Jay-esp/cb_external_pll_controller/master/design_2_0/cb_pll_master_2_0_empty.png

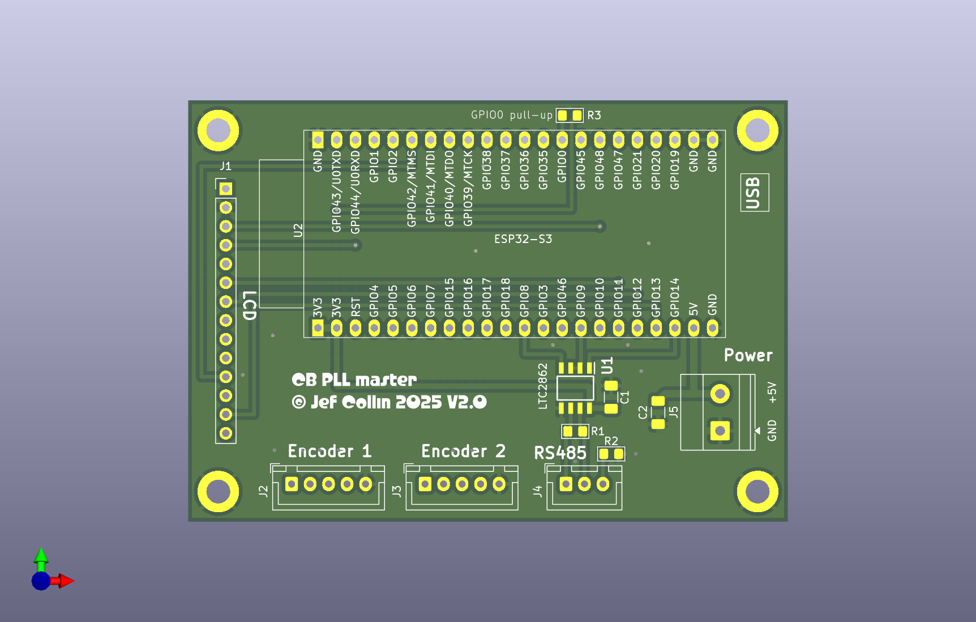
master/design_2_0/cb_pll_master_2_0_empty.png
