Jay-esp/cb_external_pll_controller/slave/design_1_2/cb_pll_slave_1_2.png

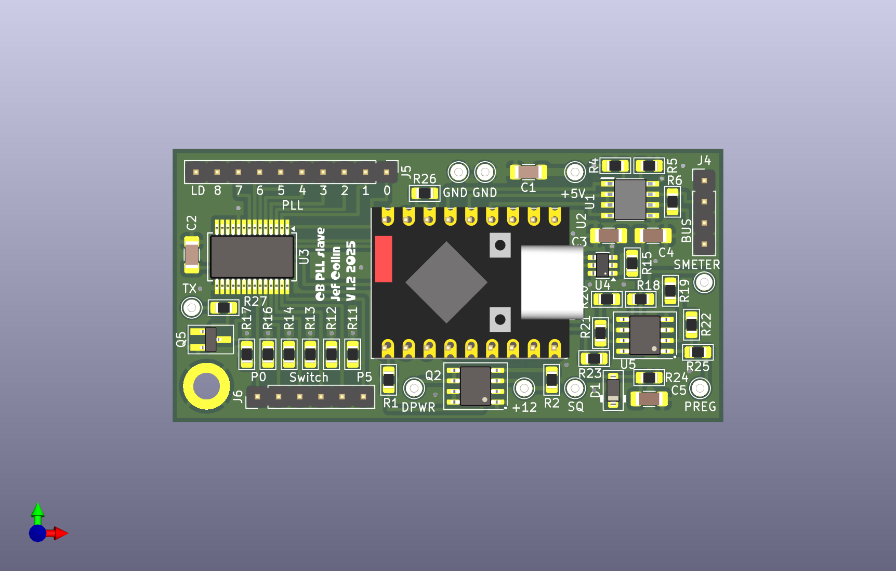
slave/design_1_2/cb_pll_slave_1_2.png
