Jay-esp/cb_external_pll_controller/master/src/cb_master_w21/dseg7_100.c

/*******************************************************************************
 * Size: 100 px
 * Bpp: 1
 * Opts: --bpp 1 --size 100 --no-compress --stride 1 --align 1 --font DSEG7Classic-Regular.ttf --symbols  0123456789., --format lvgl -o dseg7_100.c
 ******************************************************************************/

#ifdef __has_include
    #if __has_include("lvgl.h")
        #ifndef LV_LVGL_H_INCLUDE_SIMPLE
            #define LV_LVGL_H_INCLUDE_SIMPLE
        #endif
    #endif
#endif

#ifdef LV_LVGL_H_INCLUDE_SIMPLE
    #include "lvgl.h"
#else
    #include "lvgl/lvgl.h"
#endif



#ifndef DSEG7_100
#define DSEG7_100 1
#endif

#if DSEG7_100

/*-----------------
 *    BITMAPS
 *----------------*/

/*Store the image of the glyphs*/
static LV_ATTRIBUTE_LARGE_CONST const uint8_t glyph_bitmap[] = {
    /* U+0020 " " */
    0x0,

    /* U+002E "." */
    0xf, 0x3, 0xfc, 0x7f, 0xe7, 0xfe, 0xff, 0xff,
    0xff, 0xff, 0xff, 0xff, 0x7f, 0xe7, 0xfe, 0x3f,
    0xc0, 0xf0,

    /* U+0030 "0" */
    0x1, 0xff, 0xff, 0xff, 0xff, 0xff, 0xfe, 0x0,
    0xf, 0xff, 0xff, 0xff, 0xff, 0xff, 0xfc, 0x0,
    0x7f, 0xff, 0xff, 0xff, 0xff, 0xff, 0xf8, 0x1,
    0xff, 0xff, 0xff, 0xff, 0xff, 0xff, 0xe0, 0x3,
    0xff, 0xff, 0xff, 0xff, 0xff, 0xff, 0x0, 0xc7,
    0xff, 0xff, 0xff, 0xff, 0xff, 0xf8, 0xc7, 0x8f,
    0xff, 0xff, 0xff, 0xff, 0xff, 0xc7, 0xbf, 0x1f,
    0xff, 0xff, 0xff, 0xff, 0xfe, 0x3f, 0xfe, 0x3f,
    0xff, 0xff, 0xff, 0xff, 0xf1, 0xff, 0xfc, 0x0,
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
    0x80, 0x0, 0x0, 0x0, 0x0, 0x7, 0xff, 0xfe,
    0x0, 0x0, 0x0, 0x0, 0x0, 0x1f, 0xff, 0xf8,
    0x0, 0x0, 0x0, 0x0, 0x0, 0x7f, 0xff, 0xe0,
    0x0, 0x0, 0x0, 0x0, 0x1, 0xff, 0xff, 0x80,
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
};


/*---------------------
 *  GLYPH DESCRIPTION
 *--------------------*/

static const lv_font_fmt_txt_glyph_dsc_t glyph_dsc[] = {
    {.bitmap_index = 0, .adv_w = 0, .box_w = 0, .box_h = 0, .ofs_x = 0, .ofs_y = 0} /* id = 0 reserved */,
    {.bitmap_index = 0, .adv_w = 320, .box_w = 1, .box_h = 1, .ofs_x = 0, .ofs_y = 0},
    {.bitmap_index = 1, .adv_w = 0, .box_w = 12, .box_h = 12, .ofs_x = -6, .ofs_y = 0},
    {.bitmap_index = 19, .adv_w = 1306, .box_w = 62, .box_h = 100, .ofs_x = 10, .ofs_y = 0},
    {.bitmap_index = 794, .adv_w = 1306, .box_w = 9, .box_h = 92, .ofs_x = 62, .ofs_y = 4},
    {.bitmap_index = 898, .adv_w = 1306, .box_w = 62, .box_h = 100, .ofs_x = 10, .ofs_y = 0},
    {.bitmap_index = 1673, .adv_w = 1306, .box_w = 57, .box_h = 100, .ofs_x = 14, .ofs_y = 0},
    {.bitmap_index = 2386, .adv_w = 1306, .box_w = 62, .box_h = 91, .ofs_x = 10, .ofs_y = 5},
    {.bitmap_index = 3092, .adv_w = 1306, .box_w = 62, .box_h = 100, .ofs_x = 10, .ofs_y = 0},
    {.bitmap_index = 3867, .adv_w = 1306, .box_w = 62, .box_h = 100, .ofs_x = 10, .ofs_y = 0},
    {.bitmap_index = 4642, .adv_w = 1306, .box_w = 62, .box_h = 96, .ofs_x = 10, .ofs_y = 4},
    {.bitmap_index = 5386, .adv_w = 1306, .box_w = 62, .box_h = 100, .ofs_x = 10, .ofs_y = 0},
    {.bitmap_index = 6161, .adv_w = 1306, .box_w = 62, .box_h = 100, .ofs_x = 10, .ofs_y = 0}
};

/*---------------------
 *  CHARACTER MAPPING
 *--------------------*/

static const uint16_t unicode_list_0[] = {
    0x0, 0xe
};

/*Collect the unicode lists and glyph_id offsets*/
static const lv_font_fmt_txt_cmap_t cmaps[] =
{
    {
        .range_start = 32, .range_length = 15, .glyph_id_start = 1,
        .unicode_list = unicode_list_0, .glyph_id_ofs_list = NULL, .list_length = 2, .type = LV_FONT_FMT_TXT_CMAP_SPARSE_TINY
    },
    {
        .range_start = 48, .range_length = 10, .glyph_id_start = 3,
        .unicode_list = NULL, .glyph_id_ofs_list = NULL, .list_length = 0, .type = LV_FONT_FMT_TXT_CMAP_FORMAT0_TINY
    }
};



/*--------------------
 *  ALL CUSTOM DATA
 *--------------------*/

#if LVGL_VERSION_MAJOR == 8
/*Store all the custom data of the font*/
static  lv_font_fmt_txt_glyph_cache_t cache;
#endif

#if LVGL_VERSION_MAJOR >= 8
static const lv_font_fmt_txt_dsc_t font_dsc = {
#else
static lv_font_fmt_txt_dsc_t font_dsc = {
#endif
    .glyph_bitmap = glyph_bitmap,
    .glyph_dsc = glyph_dsc,
    .cmaps = cmaps,
    .kern_dsc = NULL,
    .kern_scale = 0,
    .cmap_num = 2,
    .bpp = 1,
    .kern_classes = 0,
    .bitmap_format = 0,
#if LVGL_VERSION_MAJOR == 8
    .cache = &cache
#endif

};



/*-----------------
 *  PUBLIC FONT
 *----------------*/

/*Initialize a public general font descriptor*/
#if LVGL_VERSION_MAJOR >= 8
const lv_font_t dseg7_100 = {
#else
lv_font_t dseg7_100 = {
#endif
    .get_glyph_dsc = lv_font_get_glyph_dsc_fmt_txt,    /*Function pointer to get glyph's data*/
    .get_glyph_bitmap = lv_font_get_bitmap_fmt_txt,    /*Function pointer to get glyph's bitmap*/
    .line_height = 100,          /*The maximum line height required by the font*/
    .base_line = 0,             /*Baseline measured from the bottom of the line*/
#if !(LVGL_VERSION_MAJOR == 6 && LVGL_VERSION_MINOR == 0)
    .subpx = LV_FONT_SUBPX_NONE,
#endif
#if LV_VERSION_CHECK(7, 4, 0) || LVGL_VERSION_MAJOR >= 8
    .underline_position = -12,
    .underline_thickness = 5,
#endif
    .static_bitmap = 0,
    .dsc = &font_dsc,          /*The custom font data. Will be accessed by `get_glyph_bitmap/dsc` */
#if LV_VERSION_CHECK(8, 2, 0) || LVGL_VERSION_MAJOR >= 9
    .fallback = NULL,
#endif
    .user_data = NULL,
};



#endif /*#if DSEG7_100*/
