Jay-esp/cb_external_pll_controller/master/src/cb_master_w21/dseg7_50.c

/*******************************************************************************
 * Size: 50 px
 * Bpp: 1
 * Opts: --bpp 1 --size 50 --no-compress --stride 1 --align 1 --font DSEG7Classic-Regular.ttf --symbols  0123456789-+., --format lvgl -o dseg7_50.c
 ******************************************************************************/

#ifdef __has_include
    #if __has_include("lvgl.h")
        #ifndef LV_LVGL_H_INCLUDE_SIMPLE
            #define LV_LVGL_H_INCLUDE_SIMPLE
        #endif
    #endif
#endif

#ifdef LV_LVGL_H_INCLUDE_SIMPLE
    #include "lvgl.h"
#else
    #include "lvgl/lvgl.h"
#endif



#ifndef DSEG7_50
#define DSEG7_50 1
#endif

#if DSEG7_50

/*-----------------
 *    BITMAPS
 *----------------*/

/*Store the image of the glyphs*/
static LV_ATTRIBUTE_LARGE_CONST const uint8_t glyph_bitmap[] = {
    /* U+0020 " " */
    0x0,

    /* U+002D "-" */
    0x3f, 0xff, 0xff, 0x8f, 0xff, 0xff, 0xf9, 0xff,
    0xff, 0xff, 0x1f, 0xff, 0xff, 0xc0,

    /* U+002E "." */
    0x7b, 0xff, 0xff, 0xfd, 0xe0,

    /* U+0030 "0" */
    0xf, 0xff, 0xff, 0xf0, 0x3f, 0xff, 0xff, 0xe1,
    0x3f, 0xff, 0xff, 0xb7, 0xbf, 0xff, 0xfe, 0xff,
    0x80, 0x0, 0x3, 0xff, 0x0, 0x0, 0x7, 0xfe,
    0x0, 0x0, 0xf, 0xfc, 0x0, 0x0, 0x1f, 0xf8,
    0x0, 0x0, 0x3f, 0xf0, 0x0, 0x0, 0x7f, 0xe0,
    0x0, 0x0, 0xff, 0xc0, 0x0, 0x1, 0xff, 0x80,
    0x0, 0x3, 0xff, 0x0, 0x0, 0x7, 0xfe, 0x0,
    0x0, 0xf, 0xfc, 0x0, 0x0, 0x1f, 0xf8, 0x0,
    0x0, 0x3f, 0xf0, 0x0, 0x0, 0x7f, 0xe0, 0x0,
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
    0x0, 0x0, 0x7c, 0x0, 0x0, 0x0, 0xf8, 0x0,
    0x0, 0x1, 0xf0, 0x0, 0x0, 0x3, 0xe0, 0x0,
    0x0, 0x7, 0xc1, 0xff, 0xff, 0xf7, 0x87, 0xff,
    0xff, 0xf2, 0x1f, 0xff, 0xff, 0xf0, 0x3f, 0xff,
    0xff, 0xc0
};


/*---------------------
 *  GLYPH DESCRIPTION
 *--------------------*/

static const lv_font_fmt_txt_glyph_dsc_t glyph_dsc[] = {
    {.bitmap_index = 0, .adv_w = 0, .box_w = 0, .box_h = 0, .ofs_x = 0, .ofs_y = 0} /* id = 0 reserved */,
    {.bitmap_index = 0, .adv_w = 160, .box_w = 1, .box_h = 1, .ofs_x = 0, .ofs_y = 0},
    {.bitmap_index = 1, .adv_w = 653, .box_w = 27, .box_h = 4, .ofs_x = 7, .ofs_y = 23},
    {.bitmap_index = 15, .adv_w = 0, .box_w = 6, .box_h = 6, .ofs_x = -3, .ofs_y = 0},
    {.bitmap_index = 20, .adv_w = 653, .box_w = 31, .box_h = 50, .ofs_x = 5, .ofs_y = 0},
    {.bitmap_index = 214, .adv_w = 653, .box_w = 5, .box_h = 45, .ofs_x = 31, .ofs_y = 3},
    {.bitmap_index = 243, .adv_w = 653, .box_w = 31, .box_h = 50, .ofs_x = 5, .ofs_y = 0},
    {.bitmap_index = 437, .adv_w = 653, .box_w = 29, .box_h = 50, .ofs_x = 7, .ofs_y = 0},
    {.bitmap_index = 619, .adv_w = 653, .box_w = 31, .box_h = 46, .ofs_x = 5, .ofs_y = 2},
    {.bitmap_index = 798, .adv_w = 653, .box_w = 31, .box_h = 50, .ofs_x = 5, .ofs_y = 0},
    {.bitmap_index = 992, .adv_w = 653, .box_w = 31, .box_h = 50, .ofs_x = 5, .ofs_y = 0},
    {.bitmap_index = 1186, .adv_w = 653, .box_w = 31, .box_h = 47, .ofs_x = 5, .ofs_y = 3},
    {.bitmap_index = 1369, .adv_w = 653, .box_w = 31, .box_h = 50, .ofs_x = 5, .ofs_y = 0},
    {.bitmap_index = 1563, .adv_w = 653, .box_w = 31, .box_h = 50, .ofs_x = 5, .ofs_y = 0}
};

/*---------------------
 *  CHARACTER MAPPING
 *--------------------*/

static const uint16_t unicode_list_0[] = {
    0x0, 0xd, 0xe
};

/*Collect the unicode lists and glyph_id offsets*/
static const lv_font_fmt_txt_cmap_t cmaps[] =
{
    {
        .range_start = 32, .range_length = 15, .glyph_id_start = 1,
        .unicode_list = unicode_list_0, .glyph_id_ofs_list = NULL, .list_length = 3, .type = LV_FONT_FMT_TXT_CMAP_SPARSE_TINY
    },
    {
        .range_start = 48, .range_length = 10, .glyph_id_start = 4,
        .unicode_list = NULL, .glyph_id_ofs_list = NULL, .list_length = 0, .type = LV_FONT_FMT_TXT_CMAP_FORMAT0_TINY
    }
};



/*--------------------
 *  ALL CUSTOM DATA
 *--------------------*/

#if LVGL_VERSION_MAJOR == 8
/*Store all the custom data of the font*/
static  lv_font_fmt_txt_glyph_cache_t cache;
#endif

#if LVGL_VERSION_MAJOR >= 8
static const lv_font_fmt_txt_dsc_t font_dsc = {
#else
static lv_font_fmt_txt_dsc_t font_dsc = {
#endif
    .glyph_bitmap = glyph_bitmap,
    .glyph_dsc = glyph_dsc,
    .cmaps = cmaps,
    .kern_dsc = NULL,
    .kern_scale = 0,
    .cmap_num = 2,
    .bpp = 1,
    .kern_classes = 0,
    .bitmap_format = 0,
#if LVGL_VERSION_MAJOR == 8
    .cache = &cache
#endif

};



/*-----------------
 *  PUBLIC FONT
 *----------------*/

/*Initialize a public general font descriptor*/
#if LVGL_VERSION_MAJOR >= 8
const lv_font_t dseg7_50 = {
#else
lv_font_t dseg7_50 = {
#endif
    .get_glyph_dsc = lv_font_get_glyph_dsc_fmt_txt,    /*Function pointer to get glyph's data*/
    .get_glyph_bitmap = lv_font_get_bitmap_fmt_txt,    /*Function pointer to get glyph's bitmap*/
    .line_height = 50,          /*The maximum line height required by the font*/
    .base_line = 0,             /*Baseline measured from the bottom of the line*/
#if !(LVGL_VERSION_MAJOR == 6 && LVGL_VERSION_MINOR == 0)
    .subpx = LV_FONT_SUBPX_NONE,
#endif
#if LV_VERSION_CHECK(7, 4, 0) || LVGL_VERSION_MAJOR >= 8
    .underline_position = -6,
    .underline_thickness = 3,
#endif
    .static_bitmap = 0,
    .dsc = &font_dsc,          /*The custom font data. Will be accessed by `get_glyph_bitmap/dsc` */
#if LV_VERSION_CHECK(8, 2, 0) || LVGL_VERSION_MAJOR >= 9
    .fallback = NULL,
#endif
    .user_data = NULL,
};



#endif /*#if DSEG7_50*/
