Jay-esp/cb_external_pll_controller/master/src/cb_master_w21/rystl_logo_2.c

#ifdef __has_include
    #if __has_include("lvgl.h")
        #ifndef LV_LVGL_H_INCLUDE_SIMPLE
            #define LV_LVGL_H_INCLUDE_SIMPLE
        #endif
    #endif
#endif

#if defined(LV_LVGL_H_INCLUDE_SIMPLE)
    #include "lvgl.h"
#else
    #include "lvgl/lvgl.h"
#endif


#ifndef LV_ATTRIBUTE_MEM_ALIGN
#define LV_ATTRIBUTE_MEM_ALIGN
#endif

#ifndef LV_ATTRIBUTE_IMAGE_RYSTL_LOGO_2
#define LV_ATTRIBUTE_IMAGE_RYSTL_LOGO_2
#endif

const LV_ATTRIBUTE_MEM_ALIGN LV_ATTRIBUTE_LARGE_CONST LV_ATTRIBUTE_IMAGE_RYSTL_LOGO_2 uint8_t rystl_logo_2_map[] = {
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
};

const lv_image_dsc_t rystl_logo_2 = {
  .header.cf = LV_COLOR_FORMAT_RGB565,
  .header.magic = LV_IMAGE_HEADER_MAGIC,
  .header.w = 200,
  .header.h = 150,
  .data_size = 30000 * 2,
  .data = rystl_logo_2_map,
};
