Jay-esp/cb_external_pll_controller/master/src/cb_master_w21/dseg7_28.c

/*******************************************************************************
 * Size: 28 px
 * Bpp: 1
 * Opts: --bpp 1 --size 28 --no-compress --stride 1 --align 1 --font DSEG7Classic-Regular.ttf --symbols  0.123456789.-_+ --format lvgl -o dseg7_28.c
 ******************************************************************************/

#ifdef __has_include
    #if __has_include("lvgl.h")
        #ifndef LV_LVGL_H_INCLUDE_SIMPLE
            #define LV_LVGL_H_INCLUDE_SIMPLE
        #endif
    #endif
#endif

#ifdef LV_LVGL_H_INCLUDE_SIMPLE
    #include "lvgl.h"
#else
    #include "lvgl/lvgl.h"
#endif



#ifndef DSEG7_28
#define DSEG7_28 1
#endif

#if DSEG7_28

/*-----------------
 *    BITMAPS
 *----------------*/

/*Store the image of the glyphs*/
static LV_ATTRIBUTE_LARGE_CONST const uint8_t glyph_bitmap[] = {
    /* U+0020 " " */
    0x0,

    /* U+002D "-" */
    0x7f, 0xfc, 0xff, 0xf8,

    /* U+002E "." */
    0xfc,

    /* U+0030 "0" */
    0x3f, 0xfe, 0x6f, 0xfe, 0xf8, 0x0, 0xfc, 0x0,
    0x7e, 0x0, 0x3f, 0x0, 0x1f, 0x80, 0xf, 0xc0,
    0x7, 0xe0, 0x3, 0xf0, 0x1, 0xf8, 0x0, 0xfc,
    0x0, 0x7c, 0x0, 0x1c, 0x0, 0x6, 0x0, 0x3,
    0x80, 0x3, 0xe0, 0x3, 0xf0, 0x1, 0xf8, 0x0,
    0xfc, 0x0, 0x7e, 0x0, 0x3f, 0x0, 0x1f, 0x80,
    0xf, 0xc0, 0x7, 0xe0, 0x3, 0xf0, 0x1, 0xf7,
    0xff, 0x67, 0xff, 0xc0,

    /* U+0031 "1" */
    0x7f, 0xff, 0xff, 0xff, 0xb2, 0x7f, 0xff, 0xff,
    0xff, 0x60,

    /* U+0032 "2" */
    0x3f, 0xfe, 0xf, 0xfe, 0xc0, 0x0, 0xe0, 0x0,
    0x70, 0x0, 0x38, 0x0, 0x1c, 0x0, 0xe, 0x0,
    0x7, 0x0, 0x3, 0x80, 0x1, 0xc0, 0x0, 0xe0,
    0x0, 0x70, 0x0, 0x39, 0xff, 0xf6, 0xff, 0xf9,
    0xc0, 0x0, 0xe0, 0x0, 0x70, 0x0, 0x38, 0x0,
    0x1c, 0x0, 0xe, 0x0, 0x7, 0x0, 0x3, 0x80,
    0x1, 0xc0, 0x0, 0xe0, 0x0, 0x70, 0x0, 0x37,
    0xff, 0x7, 0xff, 0xc0,

    /* U+0033 "3" */
    0xff, 0xfc, 0x7f, 0xfb, 0x0, 0x7, 0x0, 0x7,
    0x0, 0x7, 0x0, 0x7, 0x0, 0x7, 0x0, 0x7,
    0x0, 0x7, 0x0, 0x7, 0x0, 0x7, 0x0, 0x7,
    0x0, 0x7, 0xff, 0xfd, 0xff, 0xfd, 0x0, 0x7,
    0x0, 0x7, 0x0, 0x7, 0x0, 0x7, 0x0, 0x7,
    0x0, 0x7, 0x0, 0x7, 0x0, 0x7, 0x0, 0x7,
    0x0, 0x7, 0x0, 0x7, 0x7f, 0xfb, 0xff, 0xfc,

    /* U+0034 "4" */
    0x0, 0x0, 0x60, 0x0, 0xf8, 0x0, 0xfc, 0x0,
    0x7e, 0x0, 0x3f, 0x0, 0x1f, 0x80, 0xf, 0xc0,
    0x7, 0xe0, 0x3, 0xf0, 0x1, 0xf8, 0x0, 0xfc,
    0x0, 0x7b, 0xff, 0xe9, 0xff, 0xf4, 0x0, 0xe,
    0x0, 0x7, 0x0, 0x3, 0x80, 0x1, 0xc0, 0x0,
    0xe0, 0x0, 0x70, 0x0, 0x38, 0x0, 0x1c, 0x0,
    0xe, 0x0, 0x7, 0x0, 0x1, 0x80, 0x0, 0x0,

    /* U+0035 "5" */
    0x3f, 0xfe, 0x6f, 0xfe, 0x38, 0x0, 0x1c, 0x0,
    0xe, 0x0, 0x7, 0x0, 0x3, 0x80, 0x1, 0xc0,
    0x0, 0xe0, 0x0, 0x70, 0x0, 0x38, 0x0, 0x1c,
    0x0, 0xc, 0x0, 0x5, 0xff, 0xf0, 0xff, 0xfa,
    0x0, 0x7, 0x0, 0x3, 0x80, 0x1, 0xc0, 0x0,
    0xe0, 0x0, 0x70, 0x0, 0x38, 0x0, 0x1c, 0x0,
    0xe, 0x0, 0x7, 0x0, 0x3, 0x80, 0x1, 0xc7,
    0xff, 0x67, 0xff, 0xc0,

    /* U+0036 "6" */
    0x3f, 0xfe, 0x6f, 0xfe, 0x38, 0x0, 0x1c, 0x0,
    0xe, 0x0, 0x7, 0x0, 0x3, 0x80, 0x1, 0xc0,
    0x0, 0xe0, 0x0, 0x70, 0x0, 0x38, 0x0, 0x1c,
    0x0, 0xc, 0x0, 0x5, 0xff, 0xf2, 0xff, 0xfb,
    0xc0, 0x7, 0xe0, 0x3, 0xf0, 0x1, 0xf8, 0x0,
    0xfc, 0x0, 0x7e, 0x0, 0x3f, 0x0, 0x1f, 0x80,
    0xf, 0xc0, 0x7, 0xe0, 0x3, 0xf0, 0x1, 0xf7,
    0xff, 0x67, 0xff, 0xc0,

    /* U+0037 "7" */
    0x3f, 0xfe, 0x6f, 0xfe, 0xf8, 0x0, 0xfc, 0x0,
    0x7e, 0x0, 0x3f, 0x0, 0x1f, 0x80, 0xf, 0xc0,
    0x7, 0xe0, 0x3, 0xf0, 0x1, 0xf8, 0x0, 0xfc,
    0x0, 0x7c, 0x0, 0x18, 0x0, 0x0, 0x0, 0x2,
    0x0, 0x7, 0x0, 0x3, 0x80, 0x1, 0xc0, 0x0,
    0xe0, 0x0, 0x70, 0x0, 0x38, 0x0, 0x1c, 0x0,
    0xe, 0x0, 0x7, 0x0, 0x3, 0x80, 0x0, 0xc0,
    0x0, 0x0,

    /* U+0038 "8" */
    0x3f, 0xfe, 0x6f, 0xfe, 0xf8, 0x0, 0xfc, 0x0,
    0x7e, 0x0, 0x3f, 0x0, 0x1f, 0x80, 0xf, 0xc0,
    0x7, 0xe0, 0x3, 0xf0, 0x1, 0xf8, 0x0, 0xfc,
    0x0, 0x7c, 0x0, 0x3d, 0xff, 0xf6, 0xff, 0xfb,
    0xc0, 0x7, 0xe0, 0x3, 0xf0, 0x1, 0xf8, 0x0,
    0xfc, 0x0, 0x7e, 0x0, 0x3f, 0x0, 0x1f, 0x80,
    0xf, 0xc0, 0x7, 0xe0, 0x3, 0xf0, 0x1, 0xf7,
    0xff, 0x67, 0xff, 0xc0,

    /* U+0039 "9" */
    0x3f, 0xfe, 0x6f, 0xfe, 0xf8, 0x0, 0xfc, 0x0,
    0x7e, 0x0, 0x3f, 0x0, 0x1f, 0x80, 0xf, 0xc0,
    0x7, 0xe0, 0x3, 0xf0, 0x1, 0xf8, 0x0, 0xfc,
    0x0, 0x7c, 0x0, 0x3d, 0xff, 0xf4, 0xff, 0xfa,
    0x0, 0x7, 0x0, 0x3, 0x80, 0x1, 0xc0, 0x0,
    0xe0, 0x0, 0x70, 0x0, 0x38, 0x0, 0x1c, 0x0,
    0xe, 0x0, 0x7, 0x0, 0x3, 0x80, 0x1, 0xc7,
    0xff, 0x67, 0xff, 0xc0,

    /* U+005F "_" */
    0x7f, 0xfd, 0xff, 0xfc
};


/*---------------------
 *  GLYPH DESCRIPTION
 *--------------------*/

static const lv_font_fmt_txt_glyph_dsc_t glyph_dsc[] = {
    {.bitmap_index = 0, .adv_w = 0, .box_w = 0, .box_h = 0, .ofs_x = 0, .ofs_y = 0} /* id = 0 reserved */,
    {.bitmap_index = 0, .adv_w = 90, .box_w = 1, .box_h = 1, .ofs_x = 0, .ofs_y = 0},
    {.bitmap_index = 1, .adv_w = 366, .box_w = 15, .box_h = 2, .ofs_x = 4, .ofs_y = 13},
    {.bitmap_index = 5, .adv_w = 0, .box_w = 3, .box_h = 2, .ofs_x = -2, .ofs_y = 0},
    {.bitmap_index = 6, .adv_w = 366, .box_w = 17, .box_h = 28, .ofs_x = 3, .ofs_y = 0},
    {.bitmap_index = 66, .adv_w = 366, .box_w = 3, .box_h = 26, .ofs_x = 17, .ofs_y = 1},
    {.bitmap_index = 76, .adv_w = 366, .box_w = 17, .box_h = 28, .ofs_x = 3, .ofs_y = 0},
    {.bitmap_index = 136, .adv_w = 366, .box_w = 16, .box_h = 28, .ofs_x = 4, .ofs_y = 0},
    {.bitmap_index = 192, .adv_w = 366, .box_w = 17, .box_h = 26, .ofs_x = 3, .ofs_y = 1},
    {.bitmap_index = 248, .adv_w = 366, .box_w = 17, .box_h = 28, .ofs_x = 3, .ofs_y = 0},
    {.bitmap_index = 308, .adv_w = 366, .box_w = 17, .box_h = 28, .ofs_x = 3, .ofs_y = 0},
    {.bitmap_index = 368, .adv_w = 366, .box_w = 17, .box_h = 27, .ofs_x = 3, .ofs_y = 1},
    {.bitmap_index = 426, .adv_w = 366, .box_w = 17, .box_h = 28, .ofs_x = 3, .ofs_y = 0},
    {.bitmap_index = 486, .adv_w = 366, .box_w = 17, .box_h = 28, .ofs_x = 3, .ofs_y = 0},
    {.bitmap_index = 546, .adv_w = 366, .box_w = 15, .box_h = 2, .ofs_x = 4, .ofs_y = 0}
};

/*---------------------
 *  CHARACTER MAPPING
 *--------------------*/

static const uint16_t unicode_list_0[] = {
    0x0, 0xd, 0xe, 0x10, 0x11, 0x12, 0x13, 0x14,
    0x15, 0x16, 0x17, 0x18, 0x19, 0x3f
};

/*Collect the unicode lists and glyph_id offsets*/
static const lv_font_fmt_txt_cmap_t cmaps[] =
{
    {
        .range_start = 32, .range_length = 64, .glyph_id_start = 1,
        .unicode_list = unicode_list_0, .glyph_id_ofs_list = NULL, .list_length = 14, .type = LV_FONT_FMT_TXT_CMAP_SPARSE_TINY
    }
};



/*--------------------
 *  ALL CUSTOM DATA
 *--------------------*/

#if LVGL_VERSION_MAJOR == 8
/*Store all the custom data of the font*/
static  lv_font_fmt_txt_glyph_cache_t cache;
#endif

#if LVGL_VERSION_MAJOR >= 8
static const lv_font_fmt_txt_dsc_t font_dsc = {
#else
static lv_font_fmt_txt_dsc_t font_dsc = {
#endif
    .glyph_bitmap = glyph_bitmap,
    .glyph_dsc = glyph_dsc,
    .cmaps = cmaps,
    .kern_dsc = NULL,
    .kern_scale = 0,
    .cmap_num = 1,
    .bpp = 1,
    .kern_classes = 0,
    .bitmap_format = 0,
#if LVGL_VERSION_MAJOR == 8
    .cache = &cache
#endif

};



/*-----------------
 *  PUBLIC FONT
 *----------------*/

/*Initialize a public general font descriptor*/
#if LVGL_VERSION_MAJOR >= 8
const lv_font_t dseg7_28 = {
#else
lv_font_t dseg7_28 = {
#endif
    .get_glyph_dsc = lv_font_get_glyph_dsc_fmt_txt,    /*Function pointer to get glyph's data*/
    .get_glyph_bitmap = lv_font_get_bitmap_fmt_txt,    /*Function pointer to get glyph's bitmap*/
    .line_height = 28,          /*The maximum line height required by the font*/
    .base_line = 0,             /*Baseline measured from the bottom of the line*/
#if !(LVGL_VERSION_MAJOR == 6 && LVGL_VERSION_MINOR == 0)
    .subpx = LV_FONT_SUBPX_NONE,
#endif
#if LV_VERSION_CHECK(7, 4, 0) || LVGL_VERSION_MAJOR >= 8
    .underline_position = -3,
    .underline_thickness = 1,
#endif
    .static_bitmap = 0,
    .dsc = &font_dsc,          /*The custom font data. Will be accessed by `get_glyph_bitmap/dsc` */
#if LV_VERSION_CHECK(8, 2, 0) || LVGL_VERSION_MAJOR >= 9
    .fallback = NULL,
#endif
    .user_data = NULL,
};



#endif /*#if DSEG7_28*/
